AtaberkOKLU/A_Visible_Light_Communication_System/Schematic - EAGLE/Receiver.png

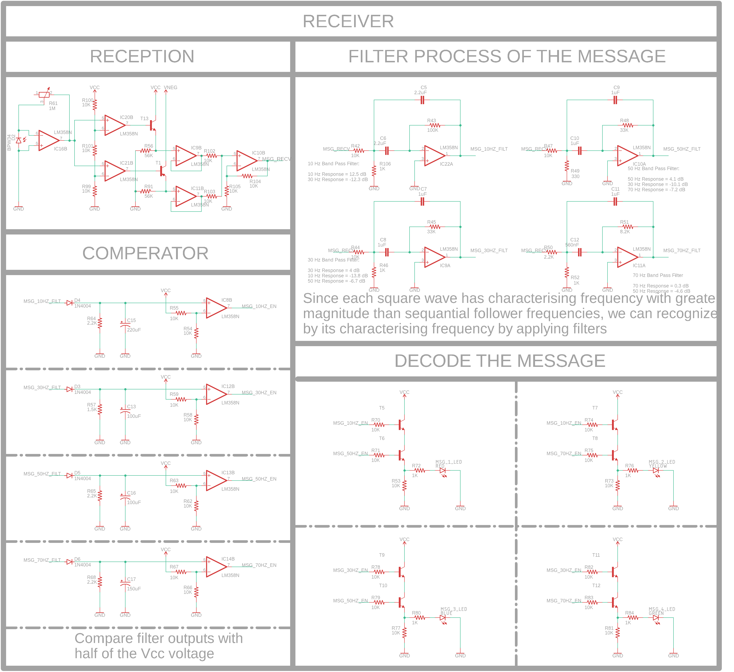
Schematic - EAGLE/Receiver.png
