AtaberkOKLU/A_Visible_Light_Communication_System/Schematic - EAGLE/Transmitter.png

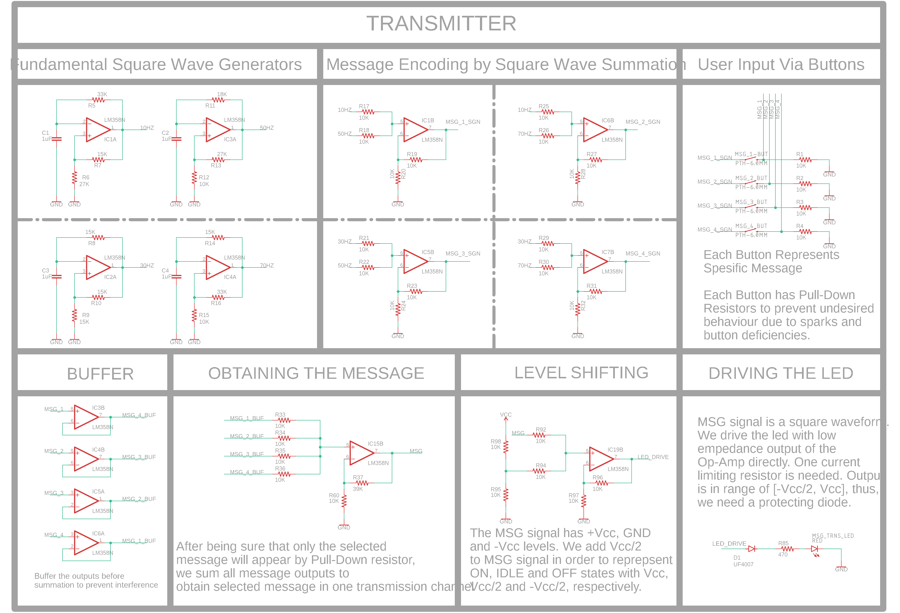
Schematic - EAGLE/Transmitter.png
