AtaberkOKLU/A_Visible_Light_Communication_System/(list of files, drawings)

Other design files:
Filters - PROTEUS/10Hz_Filter.pdsprj
Filters - PROTEUS/30Hz_Filter.pdsprj
Filters - PROTEUS/50Hz_Filter.pdsprj
Filters - PROTEUS/70Hz_Filter.pdsprj
Square Wave Generators - PROTEUS/Square_Wave_10Hz.pdsprj
Square Wave Generators - PROTEUS/Square_Wave_30Hz.pdsprj
Square Wave Generators - PROTEUS/Square_Wave_50Hz.pdsprj
Square Wave Generators - PROTEUS/Square_Wave_70Hz.pdsprj
Transmitter - PROTEUS/Transmitter-MSG1.pdsprj
