AtaberkOKLU/A_Visible_Light_Communication_System/Schematic - EAGLE/TermProject.sch

## EAGLE design Schematic - EAGLE/TermProject.sch (2020-08-03)

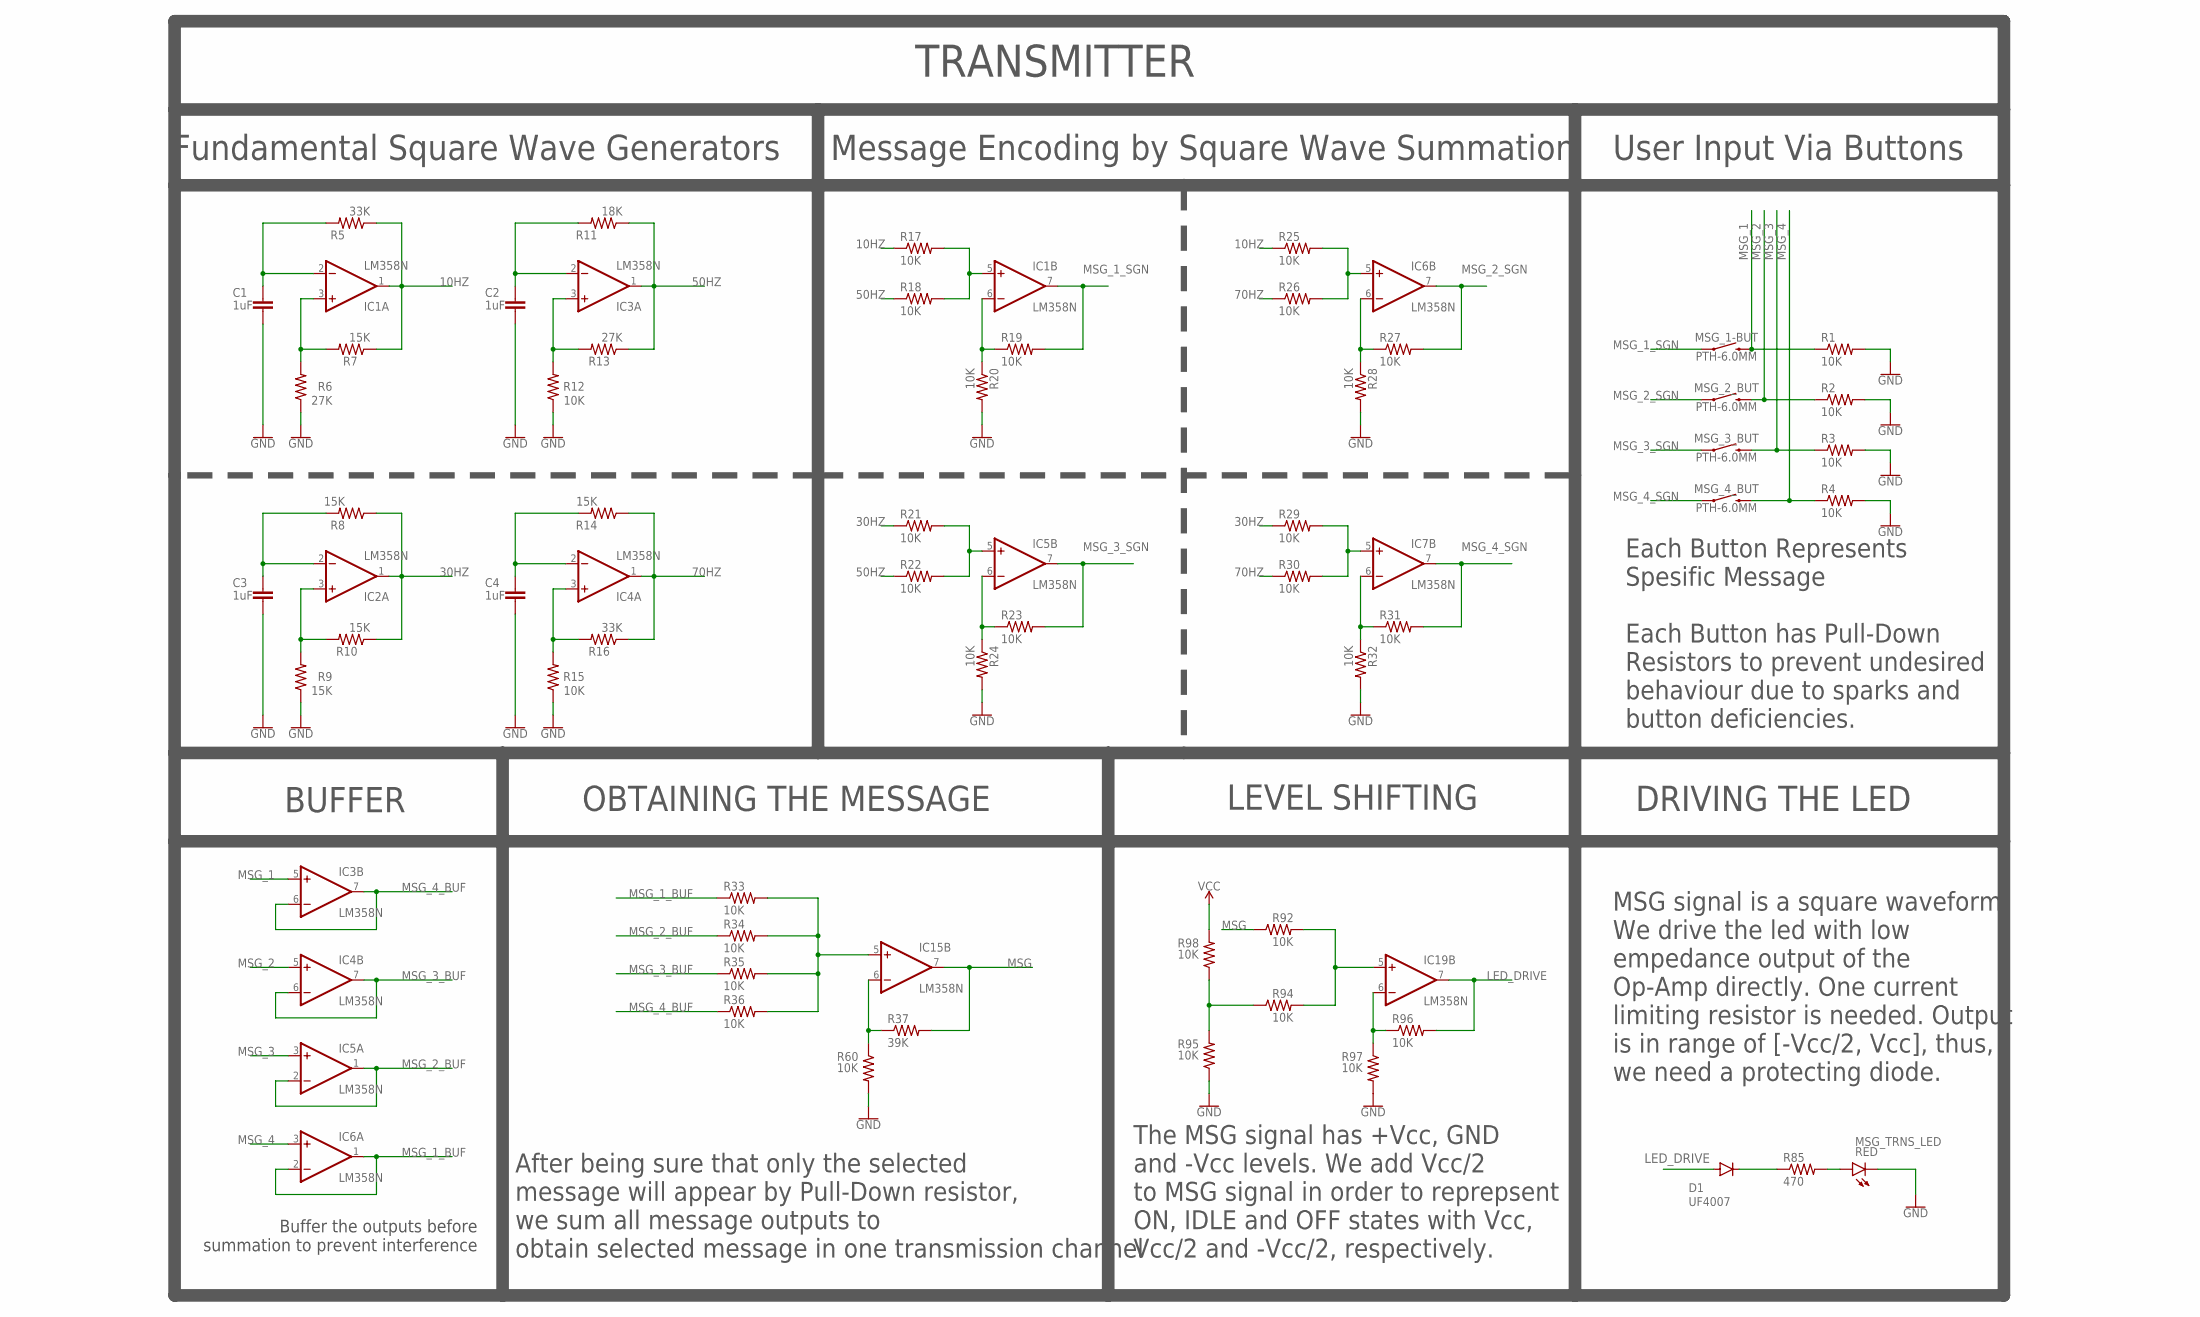
[picture p40: schematic TermProject.sch, sheet 1]

Parts:
C1, C2, C3, C4: 1uF; C075-052X106
D1: UF4007; DO35-7
IC1, IC2, IC3, IC4, IC5, IC6, IC7, IC15, IC19: LM358N; DIL08
MSG_1-BUT, MSG_2_BUT, MSG_3_BUT, MSG_4_BUT: PTH-6.0MM; TACTILE_SWITCH_PTH_6.0MM
MSG_TRNS_LED: RED; LED_10MM
R1, R2, R3, R4, R12, R15, R17, R18, R19, R20, R21, R22, R23, R24, R25, R26, R27, R28, R29, R30, R31, R32, R33, R34, R35, R36, R60, R92, R94, R95, R96, R97, R98: 10K; 0207/7
R5, R16: 33K; 0207/7
R6, R13: 27K; 0207/7
R7, R8, R9, R10, R14: 15K; 0207/7
R11: 18K; 0207/7
R37: 39K; 0207/7
R85: 470; 0207/7

Connections:
10HZ: IC1.1 (OUT), R5.1, R7.1, R17.1, R25.1
30HZ: IC2.1 (OUT), R8.1, R10.1, R21.1, R29.1
50HZ: IC3.1 (OUT), R11.1, R13.1, R18.1, R22.1
70HZ: IC4.1 (OUT), R14.1, R16.1, R26.1, R30.1
GND: C1.1, C2.1, C3.1, C4.1, MSG_TRNS_LED.C, R1.2, R2.2, R3.2, R4.2, R6.1, R9.1, R12.1, R15.1, R20.2, R24.2, R28.2, R32.2, R60.2, R95.1, R97.2
LED_DRIVE: D1.A, IC19.7 (OUT), R96.2
MSG: IC15.7 (OUT), R37.2, R92.1
MSG_1: IC3.5 (+IN), MSG_1-BUT.3 (2), R1.1
MSG_1_BUF: IC6.1 (OUT), IC6.2 (-IN), R33.1
MSG_1_SGN: IC1.7 (OUT), MSG_1-BUT.1, R19.2
MSG_2: IC4.5 (+IN), MSG_2_BUT.3 (2), R2.1
MSG_2_BUF: IC5.1 (OUT), IC5.2 (-IN), R34.1
MSG_2_SGN: IC6.7 (OUT), MSG_2_BUT.1, R27.2
MSG_3: IC5.3 (+IN), MSG_3_BUT.3 (2), R3.1
MSG_3_BUF: IC4.6 (-IN), IC4.7 (OUT), R35.1
MSG_3_SGN: IC5.7 (OUT), MSG_3_BUT.1, R23.2
MSG_4: IC6.3 (+IN), MSG_4_BUT.3 (2), R4.1
MSG_4_BUF: IC3.6 (-IN), IC3.7 (OUT), R36.1
MSG_4_SGN: IC7.7 (OUT), MSG_4_BUT.1, R31.2
unnamed: C1.2, IC1.2 (-IN), R5.2
unnamed: C3.2, IC2.2 (-IN), R8.2
unnamed: IC1.3 (+IN), R6.2, R7.2
unnamed: IC2.3 (+IN), R9.2, R10.2
unnamed: C2.2, IC3.2 (-IN), R11.2
unnamed: IC3.3 (+IN), R12.2, R13.2
unnamed: C4.2, IC4.2 (-IN), R14.2
unnamed: IC4.3 (+IN), R15.2, R16.2
unnamed: IC1.5 (+IN), R17.2, R18.2
unnamed: IC1.6 (-IN), R19.1, R20.1
unnamed: IC5.5 (+IN), R21.2, R22.2
unnamed: IC5.6 (-IN), R23.1, R24.1
unnamed: IC6.5 (+IN), R25.2, R26.2
unnamed: IC6.6 (-IN), R27.1, R28.1
unnamed: IC7.5 (+IN), R29.2, R30.2
unnamed: IC7.6 (-IN), R31.1, R32.1
unnamed: D1.C, R85.1
unnamed: IC15.6 (-IN), R37.1, R60.1
unnamed: IC15.5 (+IN), R33.2, R34.2, R35.2, R36.2
unnamed: MSG_TRNS_LED.A, R85.2
unnamed: IC19.6 (-IN), R96.1, R97.1
unnamed: R94.1, R95.2, R98.1
unnamed: IC19.5 (+IN), R92.2, R94.2
VCC: R98.2

Notes on the sheet:
User Input Via Buttons
Fundamental Square Wave Generators
Message Encoding by Square Wave Summation
Each Button Represents Spesific Message Each Button has Pull-Down Resistors to prevent undesired behaviour due to sparks and button deficiencies.
BUFFER
Buffer the outputs before summation to prevent interference
OBTAINING THE MESSAGE
TRANSMITTER
After being sure that only the selected message will appear by Pull-Down resistor, we sum all message outputs to obtain selected message in one transmission channel
LEVEL SHIFTING
MSG signal is a square waveform. We drive the led with low empedance output of the Op-Amp directly. One current limiting resistor is needed. Output is in range of [-Vcc/2, Vcc], thus, we need a protecting diode.
DRIVING THE LED
The MSG signal has +Vcc, GND and -Vcc levels. We add Vcc/2 to MSG signal in order to reprepsent ON, IDLE and OFF states with Vcc, Vcc/2 and -Vcc/2, respectively.

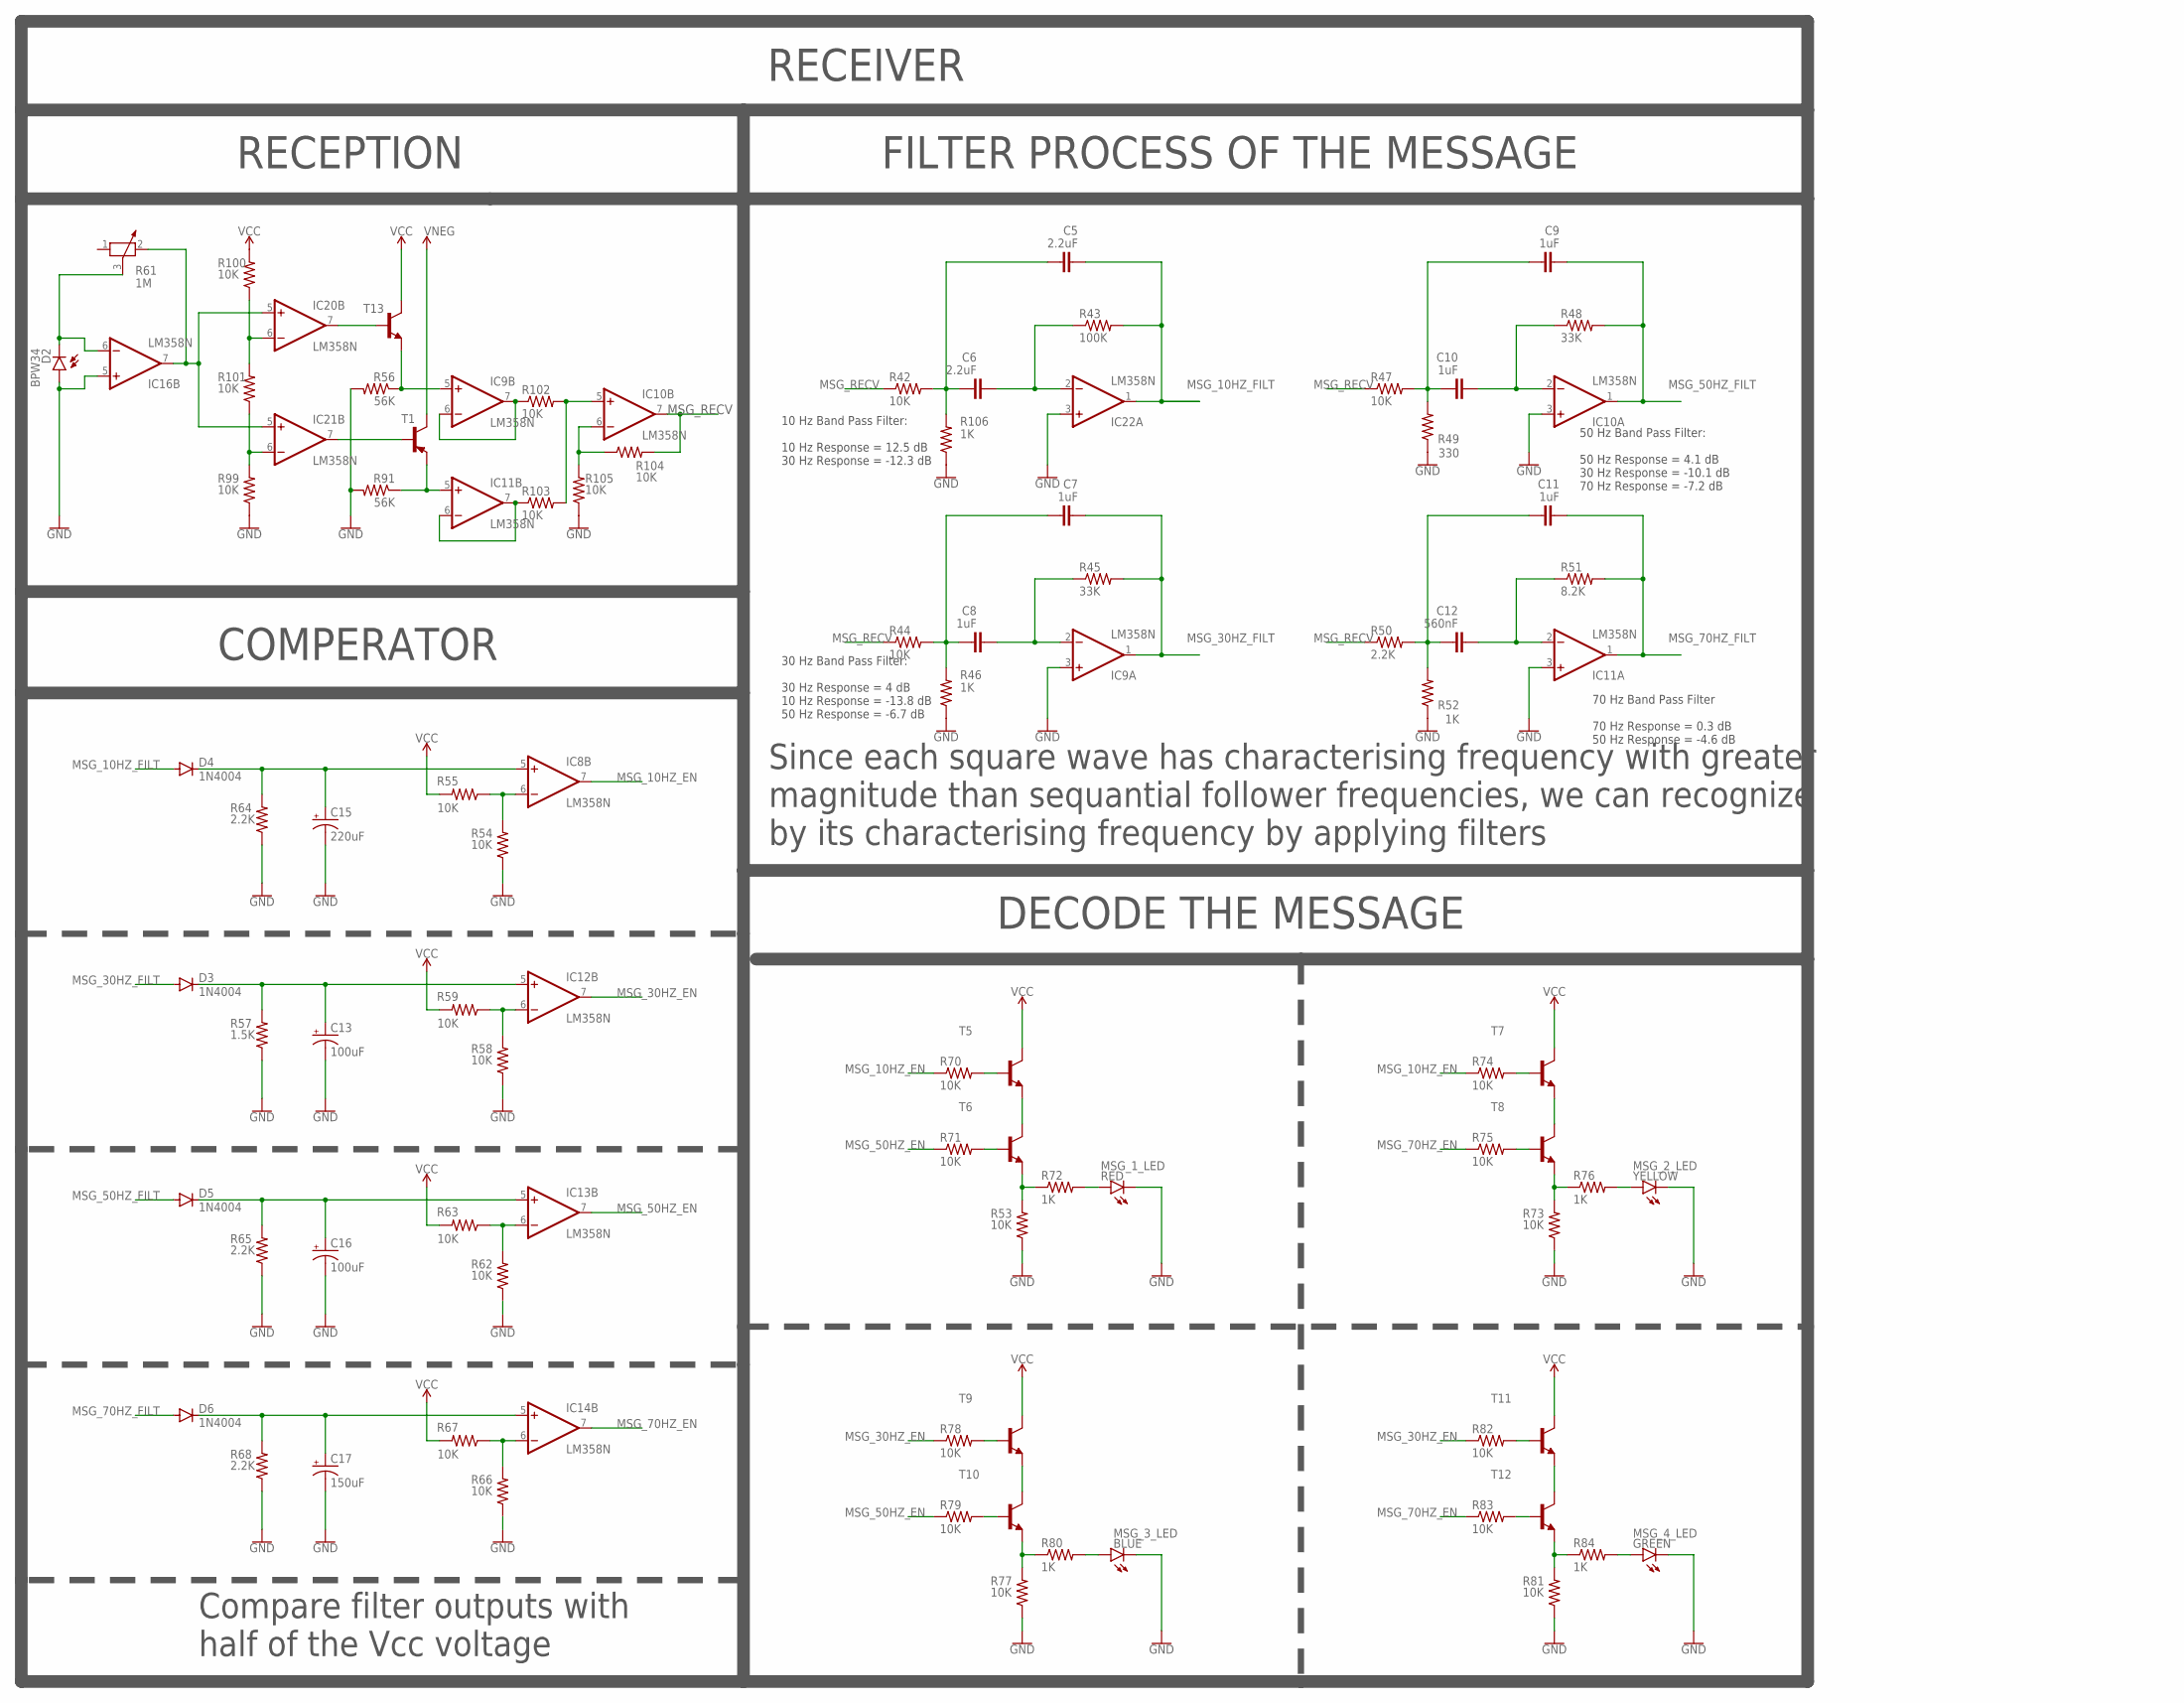
[picture p41: schematic TermProject.sch, sheet 2]

Parts:
C5, C6: 2.2uF; C075-052X106
C7, C8, C9, C10, C11: 1uF; C075-052X106
C12: 560nF; C075-052X106
C13, C16: 100uF; E5-10,5
C15: 220uF; E5-10,5
C17: 150uF; E5-10,5
D2: BPW34; BPW32
D3, D4, D5, D6: 1N4004; DO41-10
IC8, IC9, IC10, IC11, IC12, IC13, IC14, IC16, IC20, IC21, IC22: LM358N; DIL08
MSG_1_LED: RED; LED_10MM
MSG_2_LED: YELLOW; LED_10MM
MSG_3_LED: BLUE; LED_10MM
MSG_4_LED: GREEN; LED_10MM
R42, R44, R47, R53, R54, R55, R58, R59, R62, R63, R66, R67, R70, R71, R73, R74, R75, R77, R78, R79, R81, R82, R83, R99, R100, R101, R102, R103, R104, R105: 10K; 0207/7
R43: 100K; 0207/7
R45, R48: 33K; 0207/7
R46, R52, R72, R76, R80, R84, R106: 1K; 0207/7
R49: 330; 0207/7
R50, R64, R65, R68: 2.2K; 0207/7
R51: 8.2K; 0207/7
R56, R91: 56K; 0207/7
R57: 1.5K; 0207/7
R61: 1M; PT-10S
T1: BC807-40-PNP-SOT23-BEC; SOT23-BEC
T5, T6, T7, T8, T9, T10, T11, T12, T13: -NPN-TO92-CBE; TO92-CBE

Connections:
GND: C13.-, C15.-, C16.-, C17.-, D2.A, IC9.3 (+IN), IC10.3 (+IN), IC11.3 (+IN), IC16.5 (+IN), IC22.3 (+IN), MSG_1_LED.C, MSG_2_LED.C, MSG_3_LED.C, MSG_4_LED.C, R46.1, R49.1, R52.1, R53.1, R54.1, R56.2, R57.1, R58.1, R62.1, R64.1, R65.1, R66.1, R68.1, R73.1, R77.1, R81.1, R91.2, R99.1, R105.1, R106.1
INTENSİTY: IC16.7 (OUT), IC20.5 (+IN), IC21.5 (+IN), R61.2
MSG_10HZ_EN: IC8.7 (OUT), R70.1, R74.1
MSG_10HZ_FILT: D4.A
MSG_30HZ_EN: IC12.7 (OUT), R78.1, R82.1
MSG_30HZ_FILT: C7.2, D3.A, IC9.1 (OUT), R45.2
MSG_30HZ_FILT1: C5.2, IC22.1 (OUT), R43.2
MSG_50HZ_EN: IC13.7 (OUT), R71.1, R79.1
MSG_50HZ_FILT: C9.2, D5.A, IC10.1 (OUT), R48.2
MSG_70HZ_EN: IC14.7 (OUT), R75.1, R83.1
MSG_70HZ_FILT: C11.2, D6.A, IC11.1 (OUT), R51.2
MSG_NEG_OUT: IC9.5 (+IN), R56.1, T13.E
MSG_RECV: IC10.7 (OUT), R42.1, R44.1, R47.1, R50.1, R104.2
unnamed: C6.2, IC22.2 (-IN), R43.1
unnamed: C5.1, C6.1, R42.2, R106.2
unnamed: C10.2, IC10.2 (-IN), R48.1
unnamed: C8.2, IC9.2 (-IN), R45.1
unnamed: C7.1, C8.1, R44.2, R46.2
unnamed: C9.1, C10.1, R47.2, R49.2
unnamed: C12.2, IC11.2 (-IN), R51.1
unnamed: C11.1, C12.1, R50.2, R52.2
unnamed: R70.2, T5.B
unnamed: T5.E, T6.C
unnamed: R53.2, R72.1, T6.E
unnamed: R71.2, T6.B
unnamed: IC8.6 (-IN), R54.2, R55.1
unnamed: IC12.6 (-IN), R58.2, R59.1
unnamed: IC20.7 (OUT), T13.B
unnamed: C15.+, D4.C, IC8.5 (+IN), R64.2
unnamed: IC13.6 (-IN), R62.2, R63.1
unnamed: IC20.6 (-IN), R100.1, R101.2
unnamed: D2.K (C), IC16.6 (-IN), R61.3
unnamed: IC14.6 (-IN), R66.2, R67.1
unnamed: C13.+, D3.C, IC12.5 (+IN), R57.2
unnamed: C16.+, D5.C, IC13.5 (+IN), R65.2
unnamed: MSG_1_LED.A, R72.2
unnamed: T7.E, T8.C
unnamed: R73.2, R76.1, T8.E
unnamed: R74.2, T7.B
unnamed: R75.2, T8.B
unnamed: MSG_2_LED.A, R76.2
unnamed: T9.E, T10.C
unnamed: R77.2, R80.1, T10.E
unnamed: R78.2, T9.B
unnamed: R79.2, T10.B
unnamed: MSG_3_LED.A, R80.2
unnamed: T11.E, T12.C
unnamed: R81.2, R84.1, T12.E
unnamed: R82.2, T11.B
unnamed: R83.2, T12.B
unnamed: MSG_4_LED.A, R84.2
unnamed: C17.+, D6.C, IC14.5 (+IN), R68.2
unnamed: IC21.6 (-IN), R99.2, R101.1
unnamed: IC10.6 (-IN), R104.1, R105.2
unnamed: IC21.7 (OUT), T1.B
unnamed: IC11.5 (+IN), R91.1, T1.E
unnamed: IC10.5 (+IN), R102.2, R103.2
unnamed: IC9.6 (-IN), IC9.7 (OUT), R102.1
unnamed: IC11.6 (-IN), IC11.7 (OUT), R103.1
VCC: R55.2, R59.2, R63.2, R67.2, R100.2, T5.C, T7.C, T9.C, T11.C, T13.C
VNEG: T1.C

Notes on the sheet:
50 Hz Band Pass Filter: 50 Hz Response = 4.1 dB 30 Hz Response = -10.1 dB 70 Hz Response = -7.2 dB
10 Hz Band Pass Filter: 10 Hz Response = 12.5 dB 30 Hz Response = -12.3 dB
30 Hz Band Pass Filter: 30 Hz Response = 4 dB 10 Hz Response = -13.8 dB 50 Hz Response = -6.7 dB
70 Hz Band Pass Filter 70 Hz Response = 0.3 dB 50 Hz Response = -4.6 dB
FILTER PROCESS OF THE MESSAGE
Since each square wave has characterising frequency with greater magnitude than sequantial follower frequencies, we can recognize by its characterising frequency by applying filters
Compare filter outputs with half of the Vcc voltage
DECODE THE MESSAGE
COMPERATOR
RECEPTION
RECEIVER
